munetomo-maruyama/bfCPU/RTL/UART/sasc/trunk/rtl/verilog/sasc_top.v

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
//  CVS Log
//
//  $Id: sasc_top.v,v 1.2 2006-03-30 02:47:07 rudi Exp $
//
//  $Date: 2006-03-30 02:47:07 $
//  $Revision: 1.2 $
//  $Author: rudi $
//  $Locker:  $
//  $State: Exp $
//
// Change History:
//               $Log: not supported by cvs2svn $
//               Revision 1.1.1.1  2002/09/16 16:16:42  rudi
//               Initial Checkin
//
//
//
//
//
//
//
//

//`include "timescale.v"


/*
Serial IO Interface
===============================
RTS I Request To Send
CTS O Clear to send
TD  I Transmit Data
RD  O Receive Data
*/

module sasc_top(	clk, rst,
	
			// SIO
			rxd_i, txd_o, cts_i, rts_o, 

			// External Baud Rate Generator
			sio_ce, sio_ce_x4,

			// Internal Interface
			din_i, dout_o, re_i, we_i, full_o, empty_o);

input		clk;
input		rst;
input		rxd_i;
output		txd_o;
input		cts_i;
output		rts_o; 
input		sio_ce;
input		sio_ce_x4;
input	[7:0]	din_i;
output	[7:0]	dout_o;
input		re_i, we_i;
output		full_o, empty_o;

///////////////////////////////////////////////////////////////////
//
// Local Wires and Registers
//

parameter	START_BIT	= 1'b0,
		STOP_BIT	= 1'b1,
		IDLE_BIT	= 1'b1;

wire	[7:0]	txd_p;
reg		load;
reg		load_r;
wire		load_e;
reg	[9:0]	hold_reg;
wire		txf_empty;
reg		txd_o;
reg		shift_en;
reg	[3:0]	tx_bit_cnt;
reg		rxd_s, rxd_r;
wire		start;
reg	[3:0]	rx_bit_cnt;
reg		rx_go;
reg	[9:0]	rxr;
reg		rx_valid, rx_valid_r;
wire		rx_we;
wire		rxf_full;
reg		rts_o;
reg		txf_empty_r;
reg		shift_en_r;
reg		rxd_r1, rxd_r2;
//wire		lock_en;
reg		change;
reg		rx_sio_ce_d, rx_sio_ce_r1, rx_sio_ce_r2, rx_sio_ce;
reg	[1:0]	dpll_state, dpll_next_state;
reg 	[5:0] 	rxd_dly; //New input delay used to ensure no baud clocks
			// occur twice in one baud period

wire _unused;
assign _unused = load_r & rxr[0] & rxd_r2;            
            
///////////////////////////////////////////////////////////////////
//
// IO Fifo's
//

sasc_fifo4 tx_fifo(	.clk(		clk		),
			.rst(		rst		),
			.clr(		1'b0		),
			.din(		din_i		),
			.we(		we_i		),
			.dout(		txd_p		),
			.re(		load_e		),
			.full(		full_o		),
			.empty(		txf_empty	)
			);

sasc_fifo4 rx_fifo(	.clk(		clk		),
			.rst(		rst		),
			.clr(		1'b0		),
			.din(		rxr[9:2]	),
			.we(		rx_we		),
			.dout(		dout_o		),
			.re(		re_i		),
			.full(		rxf_full	),
			.empty(		empty_o		)
			);

///////////////////////////////////////////////////////////////////
//
// Transmit Logic
//
always @(posedge clk or negedge rst)
	if(!rst)	txf_empty_r <= 1'b1;
	else
	if(sio_ce)	txf_empty_r <= txf_empty;

always @(posedge clk)
	load <= !txf_empty_r & !shift_en & !cts_i;

always @(posedge clk)
	load_r <= load;

assign load_e = load & sio_ce;

always @(posedge clk)
	if(load_e)		hold_reg <= {STOP_BIT, txd_p, START_BIT};
	else
	if(shift_en & sio_ce)	hold_reg <= {IDLE_BIT, hold_reg[9:1]};

always @(posedge clk or negedge rst)
	if(!rst)				txd_o <= IDLE_BIT;
	else
	if(sio_ce)
		if(shift_en | shift_en_r)	txd_o <= hold_reg[0];
		else				txd_o <= IDLE_BIT;

always @(posedge clk or negedge rst)
        if(!rst)		tx_bit_cnt <= 4'h9;
	else
	if(load_e)		tx_bit_cnt <= 4'h0;
	else
	if(shift_en & sio_ce)	tx_bit_cnt <= tx_bit_cnt + 4'h1;

always @(posedge clk)
	shift_en <= (tx_bit_cnt != 4'h9);

always @(posedge clk  or negedge rst)
	if(!rst)	shift_en_r <= 1'b0;
	else
	if(sio_ce)	shift_en_r <= shift_en;

///////////////////////////////////////////////////////////////////
//
// Recieve Logic
//

always @(posedge clk)
begin
    rxd_dly[5:1] <= rxd_dly[4:0];
	 rxd_dly[0] <= rxd_i;
	 rxd_s <= rxd_dly[5];  // rxd_s = delay 1
    rxd_r <= rxd_s;  // rxd_r = delay 2	 
end


assign start = (rxd_r == IDLE_BIT) & (rxd_s == START_BIT);

always @(posedge clk or negedge rst)
        if(!rst)		rx_bit_cnt <= 4'ha;
	else
	if(!rx_go & start)	rx_bit_cnt <= 4'h0;
	else
	if(rx_go & rx_sio_ce)	rx_bit_cnt <= rx_bit_cnt + 4'h1;

always @(posedge clk)
	rx_go <= (rx_bit_cnt != 4'ha);

always @(posedge clk)
	rx_valid <= (rx_bit_cnt == 4'h9);

always @(posedge clk)
	rx_valid_r <= rx_valid;

assign rx_we = !rx_valid_r & rx_valid & !rxf_full;

always @(posedge clk)
	if(rx_go & rx_sio_ce)	rxr <= {rxd_s, rxr[9:1]};

always @(posedge clk)
	rts_o <= rxf_full;

///////////////////////////////////////////////////////////////////
//
// Reciever DPLL
//

// Uses 4x baud clock to lock to incoming stream

// Edge detector
//always @(posedge clk)
always @(posedge clk or negedge rst)
    if(!rst)        
        rxd_r1 <= 1'b1;
	else if(sio_ce_x4)
        rxd_r1 <= rxd_s;

always @(posedge clk)
	if(sio_ce_x4)	rxd_r2 <= rxd_r1;

always @(posedge clk or negedge rst)
    if(!rst)        
        change <= 1'b0;
    else if ((rxd_dly[1] != rxd_r1) || (rxd_dly[1] != rxd_s))
        change <= 1'b1;
    else if(sio_ce_x4)
        change <= 1'b0;

// DPLL FSM
always @(posedge clk or negedge rst)
	if(!rst)	dpll_state <= 2'h1;
	else
	if(sio_ce_x4)	dpll_state <= dpll_next_state;

//always @(dpll_state or change)
always @*
   begin
	rx_sio_ce_d = 1'b0;
	case(dpll_state)
	   2'h0:
		if(change)	dpll_next_state = 2'h0;
		else		dpll_next_state = 2'h1;
	   2'h1:begin
		rx_sio_ce_d = 1'b1;
		if(change)	dpll_next_state = 2'h3;
		else		dpll_next_state = 2'h2;
		end
	   2'h2:
		if(change)	dpll_next_state = 2'h0;
		else		dpll_next_state = 2'h3;
	   2'h3:
		if(change)	dpll_next_state = 2'h0;
		else		dpll_next_state = 2'h0;
	endcase
   end

// Compensate for sync registers at the input - allign sio 
// clock enable to be in the middle between two bit changes ...
always @(posedge clk)
	rx_sio_ce_r1 <= rx_sio_ce_d;

always @(posedge clk)
	rx_sio_ce_r2 <= rx_sio_ce_r1;

always @(posedge clk)
	rx_sio_ce <= rx_sio_ce_r1 & !rx_sio_ce_r2;

endmodule
