munetomo-maruyama/bfCPU/SIM/tb_TOP/ROM/life.v

@00 02
@01 20
@02 22
@03 62
@04 21
@05 22
@06 02
@07 73
@08 61
@09 21
@0a 22
@0b 22
@0c 02
@0d 73
@0e 62
@0f 61
@10 00
@11 00
@12 12
@13 11
@14 31
@15 07
@16 00
@17 60
@18 11
@19 11
@1a 02
@1b 00
@1c 00
@1d 20
@1e 11
@1f 73
@20 21
@21 22
@22 62
@23 20
@24 22
@25 22
@26 22
@27 12
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
@aa 06
@ab 20
@ac 20
@ad 11
@ae 31
@af 07
@b0 36
@b1 60
@b2 11
@b3 11
@b4 02
@b5 00
@b6 30
@b7 17
@b8 16
@b9 11
@ba 21
@bb 00
@bc 00
@bd 73
@be 11
@bf 11
@c0 17
@c1 22
@c2 22
@c3 22
@c4 22
@c5 62
@c6 20
@c7 22
@c8 22
@c9 31
@ca 07
@cb 60
@cc 11
@cd 02
@ce 30
@cf 17
@d0 61
@d1 30
@d2 33
@d3 31
@d4 07
@d5 64
@d6 73
@d7 11
@d8 11
@d9 11
@da 11
@db 11
@dc 11
@dd 11
@de 11
@df 31
@e0 27
@e1 22
@e2 22
@e3 22
@e4 22
@e5 42
@e6 36
@e7 17
@e8 73
@e9 00
@ea 00
@eb 36
@ec 17
@ed 36
@ee 27
@ef 22
@f0 22
@f1 22
@f2 62
@f3 20
@f4 22
@f5 22
@f6 22
@f7 12
@f8 73
@f9 30
@fa 43
@fb 36
@fc 17
@fd 35
@fe 33
@ff 33
@100 33
@101 33
@102 63
@103 21
@104 30
@105 07
@106 00
@107 00
@108 20
@109 11
@10a 11
@10b 11
@10c 61
@10d 20
@10e 00
@10f 00
@110 20
@111 60
@112 73
@113 11
@114 11
@115 11
@116 31
@117 07
@118 22
@119 22
@11a 22
@11b 22
@11c 22
@11d 00
@11e 00
@11f 60
@120 36
@121 17
@122 51
@123 11
@124 11
@125 11
@126 31
@127 00
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
@1aa 00
@1ab 12
@1ac 11
@1ad 31
@1ae 07
@1af 00
@1b0 07
@1b1 00
@1b2 16
@1b3 11
@1b4 02
@1b5 00
@1b6 73
@1b7 12
@1b8 11
@1b9 06
@1ba 00
@1bb 13
@1bc 11
@1bd 73
@1be 60
@1bf 03
@1c0 16
@1c1 11
@1c2 21
@1c3 00
@1c4 00
@1c5 73
@1c6 61
@1c7 11
@1c8 11
@1c9 02
@1ca 00
@1cb 30
@1cc 17
@1cd 11
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
@414 00
@415 00
@416 60
@417 11
@418 21
@419 00
@41a 30
@41b 17
@41c 11
@41d 06
@41e 00
@41f 12
@420 11
@421 11
@422 11
@423 11
@424 02
@425 00
@426 00
@427 30
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
@4aa 73
@4ab 31
@4ac 07
@4ad 00
@4ae 00
@4af 00
@4b0 00
@4b1 00
@4b2 36
@4b3 17
@4b4 71
@4b5 11
@4b6 11
@4b7 11
@4b8 11
@4b9 11
@4ba f7
