munetomo-maruyama/bfCPU/SIM/tb_TOP/ROM/tictactoe.v

@00 33
@01 03
@02 33
@03 03
@04 00
@05 30
@06 30
@07 30
@08 00
@09 00
@0a 30
@0b 03
@0c 00
@0d 00
@0e 00
@0f 00
@10 00
@11 00
@12 00
@13 00
@14 20
@15 00
@16 22
@17 22
@18 22
@19 22
@1a 22
@1b 16
@1c 21
@1d 62
@1e 33
@1f 21
@20 11
@21 12
@22 21
@23 00
@24 00
@25 06
@26 16
@27 03
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
@aa 17
@ab 06
@ac 07
@ad 66
@ae 70
@af 02
@b0 22
@b1 22
@b2 22
@b3 22
@b4 12
@b5 31
@b6 16
@b7 77
@b8 07
@b9 06
@ba 00
@bb 70
@bc 17
@bd 36
@be 66
@bf 20
@c0 20
@c1 11
@c2 73
@c3 60
@c4 21
@c5 30
@c6 27
@c7 02
@c8 02
@c9 70
@ca 61
@cb 11
@cc 22
@cd 36
@ce 03
@cf 60
@d0 73
@d1 07
@d2 66
@d3 73
@d4 60
@d5 11
@d6 02
@d7 30
@d8 07
@d9 77
@da 17
@db 66
@dc 16
@dd 71
@de 63
@df 00
@e0 17
@e1 12
@e2 73
@e3 60
@e4 13
@e5 72
@e6 11
@e7 16
@e8 71
@e9 13
@ea 06
@eb 26
@ec 00
@ed 07
@ee 06
@ef 07
@f0 36
@f1 77
@f2 60
@f3 26
@f4 00
@f5 17
@f6 33
@f7 00
@f8 06
@f9 27
@fa 00
@fb 70
@fc 17
@fd 36
@fe 36
@ff 63
@100 12
@101 11
@102 31
@103 63
@104 02
@105 36
@106 07
@107 16
@108 21
@109 20
@10a 30
@10b 17
@10c 61
@10d 00
@10e 12
@10f 31
@110 77
@111 22
@112 06
@113 77
@114 11
@115 06
@116 02
@117 12
@118 31
@119 07
@11a 33
@11b 16
@11c 02
@11d 73
@11e 22
@11f 00
@120 70
@121 61
@122 11
@123 61
@124 73
@125 22
@126 02
@127 36
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
@1aa 00
@1ab 07
@1ac 06
@1ad 77
@1ae 71
@1af 17
@1b0 87
