munetomo-maruyama/bfCPU/bfTool/samples/life.asm

//                          Linus Akesson presents:
//                 The Game Of Life implemented in Brainfuck

       +>>++++[<++++>-]<[<++++++>-]+[<[>>>>+<<<<-]>>>>[<<<<+>>>>>>+<<-]<+
   +++[>++++++++<-]>.[-]<+++[>+++<-]>+[>>.+<<-]>>[-]<<<++[<+++++>-]<.<<[>>>>+
 <<<<-]>>>>[<<<<+>>>>>>+<<-]<<[>>>>.+<<<++++++++++[<[>>+<<-]>>[<<+>>>>>++++++++
 +++<<<-]<[>+<-]>[<+>>>>+<<<-]>>>[>>>>>>>>>>>>+>+<<     <<<<<<<<<<<-]>>>>>>>>>>
>>[-[>>>>+<<<<-]>[>>>>+<<<<-]>>>]>      >>[<<<+>>  >-    ]<<<[>>+>+<<<-]>[->[<<<
<+>>>>-]<[<<<  <+>      >>>-]<<<< ]<     ++++++  ++       +[>+++++<-]>>[<<+>>-]<
<[>---<-]>.[- ]         <<<<<<<<< <      <<<<<< <         -]++++++++++.[-]<-]>>>
>[-]<[-]+++++           +++[>++++        ++++<     -     ]>--.[-]<,----------[<+
>-]>>>>>>+<<<<< <     <[>+>>>>>+>[      -]<<<      <<   <<-]>++++++++++>>>>>[[-]
<<,<<<<<<<->>>> >    >>[<<<<+>>>>-]<<<<[>>>>+      >+<<<<<-]>>>>>----------[<<<<
<<<<+<[>>>>+<<<      <-]>>>>[<<<<+>>>>>>+<<-      ]>[>-<-]>++++++++++[>+++++++++
++<-]<<<<<<[>>>      >+<<<<-]>>>>[<<<<+>>>>>      >+<<-]>>>>[<<->>-]<<++++++++++
[>+<-]>[>>>>>>>      >>>>>+>+<<<<      <<<<<      <<<<-]>>> >>     >>>>>>>[-[>>>
>+<<<<-]>[>>>>       +<<<<-]>> >       ]>> >           [<< <        +>>>-]+<<<[>
>>-<<<-]>[->[<      <<<+>>>>-]         <[ <            < <           <+>>>>-]<<<
<]<<<<<<<<<<<, [    -]]>]>[-+++        ++               +    +++     ++[>+++++++
++++>+++++++++ +    +<<-]>[-[>>>      +<<<-      ]>>>[ <    <<+      >>>>>>>+>+<
<<<<-]>>>>[-[> >    >>+<<<<-]>[>      >>>+< <    <<-]> >    >]>      >>[<<<+>>>-
]<<<[>>+>+<<< -     ]>[->[<<<<+>      >>>-] <    [<<< <    +>>       >>-]<<<<]<<
<<<<<<[>>>+<< <     -]>>>[<<<+>>      >>>>> +    >+<< <             <<-]<<[>>+<<
-]>>[<<+>>>>>      >+>+<<<<<-]>>      >>[-[ >    >>>+ <            <<<-]>[>>>>+<
<<<-]>[>>>>+<      <<<-]>>]>>>[ -    ]<[>+< -    ]<[ -           [<<<<+>>>>-]<<<
<]<<<<<<<<]<<      <<<<<<<<++++ +    +++++  [   >+++ +    ++++++[<[>>+<<-]>>[<<+
>>>>>++++++++ +    ++<<<     -] <    [>+<- ]    >[<+ >    >>>+<<<-]>>>[<<<+>>>-]
<<<[>>>+>>>>  >    +<<<<     <<      <<-]> >    >>>>       >>>[>>+<<-]>>[<<+<+>>
>-]<<<------ -    -----[     >>      >+<<< -    ]>>>       [<<<+> > >>>>>+>+<<<<
<-]>>>>[-[>> >    >+<<<<    -] >     [>>>> +    <<<<-       ]>>> ]  >>>[<<<+>>>-
]<<<[>>+>+<< <    -]>>>     >>           > >    [<<<+               >>>-]<<<[>>>
+<<<<<+>>-                  ]>           >     >>>>>[<             <<+>>>-]<<<[>
>>+<<<<<<<                  <<+         >      >>>>>-]<          <<<<<<[->[<<<<+
>>>>-]<[<<<<+>>>>-]<<<<]>[<<<<<<    <+>>>      >>>>-]<<<<     <<<<<+++++++++++[>
>>+<<<-]>>>[<<<+>>>>>>>+>+<<<<<-]>>>>[-[>     >>>+<<<<-]>[>>>>+<<<<-]>>>]>>>[<<<
+>>>-]<<<[>>+>+<<<-]>>>>>>>[<<<+>>>-]<<<[     >>>+<<<<<+>>-]>>>>>>>[<<<+>>>-]<<<
[>>>+<<<<<<<<<+>>>>>>-]<<<<<<<[->[< <  <     <+>>>>-]<[<<<<+>>>>-]<<<<]>[<<<<<<<
+>>>>>>>-]<<<<<<<<<+++++++++++[>>> >        >>>+>+<<<<<<<<-]>>>>>>>[-[>>>>+<<<<-
]>[>>>>+<<<<-]>>>]>>>[<<<+>>>-]<<< [       >>+>+<<<-]>>>>>>>[<<<+>>>-]<<<[>>>+<<
<<<+>>-]>>>>>>>[<<<+>>>-]<<<[>>>+<        <<<<<<<<+>>>>>>-]<<<<<<<[->[<<<<+>>>>-
 ]<[<<<<+>>>>-]<<<<]>[<<<<<<<+>>>>>      >>-]<<<<<<<----[>>>>>>>+<<<<<<<+[>>>>>
 >>-<<<<<<<[-]]<<<<<<<[>>>>>>>>>>>>+>+<<<<<<<<<<<<<-][                   ]>>>>>
   >>>>>>>[-[>>>>+<<<<-]>[>>>>+<<<<-]>[>>>>+<<<<-]>>]>>>[-]<[>+<-]<[-[<<<<+>>
       >>-]<<<<]<<<<<<[-]]<<<<<<<[-]<<<<-]<-]>>>>>>>>>>>[-]<<]<<<<<<<<<<]

//      Type for instance "fg" to toggle the cell at row f and column g
//                 Hit enter to calculate the next generation
//                               Type q to quit
