munetomo-maruyama/bfCPU/SIM/tb_TOP/ROM/cache.v

@00 26
@01 07
@02 02
@03 22
@04 20
@05 22
@06 20
@07 22
@08 02
@09 22
@0a 22
@0b 02
@0c 22
@0d 22
@0e 22
@0f 20
@10 22
@11 22
@12 22
@13 20
@14 22
@15 22
@16 22
@17 02
@18 22
@19 22
@1a 22
@1b 22
@1c 02
@1d 22
@1e 22
@1f 22
@20 22
@21 22
@22 20
@23 22
@24 22
@25 22
@26 22
@27 22
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
@4e ff
@4f 8f
