munetomo-maruyama/bfCPU/SIM/tb_TOP/ROM/helloworld.v

@00 22
@01 22
@02 22
@03 22
@04 06
@05 22
@06 22
@07 06
@08 22
@09 20
@0a 22
@0b 20
@0c 22
@0d 20
@0e 11
@0f 11
@10 73
@11 20
@12 20
@13 30
@14 00
@15 62
@16 71
@17 31
@18 07
@19 40
@1a 30
@1b 33
@1c 24
@1d 22
@1e 22
@1f 22
@20 44
@21 22
@22 42
@23 00
@24 14
@25 43
@26 41
@27 22
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
