munetomo-maruyama/bfCPU/SIM/tb_TOP/ROM/inputdec.v

@00 36
@01 07
@02 36
@03 27
@04 66
@05 73
@06 60
@07 73
@08 65
@09 62
@0a 33
@0b 33
@0c 33
@0d 33
@0e 33
@0f 63
@10 60
@11 73
@12 22
@13 22
@14 22
@15 16
@16 33
@17 33
@18 33
@19 30
@1a 17
@1b 33
@1c 11
@1d 36
@1e 00
@1f 22
@20 22
@21 22
@22 22
@23 22
@24 11
@25 07
@26 60
@27 13
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
