munetomo-maruyama/bfCPU/SIM/tb_TOP/ROM/printdec.v

@00 20
@01 22
@02 22
@03 22
@04 22
@05 22
@06 36
@07 21
@08 22
@09 22
@0a 22
@0b 22
@0c 22
@0d 22
@0e 22
@0f 70
@10 20
@11 22
@12 22
@13 22
@14 22
@15 12
@16 61
@17 03
@18 02
@19 63
@1a 20
@1b 00
@1c 07
@1d 26
@1e 36
@1f 21
@20 70
@21 20
@22 00
@23 17
@24 11
@25 11
@26 71
@27 00
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
