munetomo-maruyama/bfCPU/bfTool/samples/cache.asm

//====================================
// Cache Test
//====================================
// ptr=0
[+]
// ptr=1
p++
inc
// ptr=2
p++
inc
inc
// ptr=3
p++
inc
inc
inc
// ptr=4
p++
inc
inc
inc
inc
// ptr=5
p++
inc
inc
inc
inc
inc
// ptr=6
p++
inc
inc
inc
inc
inc
inc
// ptr=7
p++
inc
inc
inc
inc
inc
inc
inc
// ptr=8
p++
inc
inc
inc
inc
inc
inc
inc
inc
// ptr=9
p++
inc
inc
inc
inc
inc
inc
inc
inc
inc
// ptr=10
p++
inc
inc
inc
inc
inc
inc
inc
inc
inc
inc
// ptr=11
p++
inc
inc
inc
inc
inc
inc
inc
inc
inc
inc
inc
// ptr=12
p++
inc
inc
inc
inc
inc
inc
inc
inc
inc
inc
inc
inc
// ptr=13
p++
inc
inc
inc
inc
inc
inc
inc
inc
inc
inc
inc
inc
inc
// ptr=14
p++
inc
inc
inc
inc
inc
inc
inc
inc
inc
inc
inc
inc
inc
inc
// ptr=15
p++
inc
inc
inc
inc
inc
inc
inc
inc
inc
inc
inc
inc
inc
inc
inc
// ptr=16
p++
inc
inc
inc
inc
inc
inc
inc
inc
inc
inc
inc
inc
inc
inc
inc
inc
//
nop
nop
nop
nop
reset // to pause simulation
