munetomo-maruyama/bfCPU/bfTool/samples/helloworld.asm

//====================================
// Hello World
//====================================
++++++++[>++++[>++>+++>+++>+<<<<-]>+>+>->>+[<]<-]>>.>---.+++++++..+++.>>.<-.<.+++.------.--------.>>+.>++.

reset // to pause simulation
