munetomo-maruyama/bfCPU/bfTool/samples/multiplication.asm

//====================================
// Multiplicaton
//====================================
in    // ptr=0
p++
in    // ptr=1
p--
//
[->[->+>+<<]>>[-<<+>>]<<<]
//
p++
p++
out   // ptr=2
//
reset // to pause simulation
nop
nop
nop
nop
nop
nop
nop
nop
