munetomo-maruyama/bfCPU/(commit log)

2026-01-19 Upload from local
    [FPGA.smp_dump.txt]
2026-03-05 Updated bfTool to fix core dump.
    [main.c]
