munetomo-maruyama/bfCPU/(notices)

Notices in the files:
RTL/UART/sasc/trunk/rtl/verilog/sasc_top.v:
Copyright (C) 2000-2002 Rudolf Usselmann
RTL/QSPI_SRAM/23LC512.v:
This information is distributed under license from Young Engineering.
COPYRIGHT (c) 2014 YOUNG ENGINEERING
ALL RIGHTS RESERVED
